MarcSerraPeralta/custom-keyboards/documentation/build_guide/hotswap_socket_mounting/hotswap_sockets_installation_1.webp

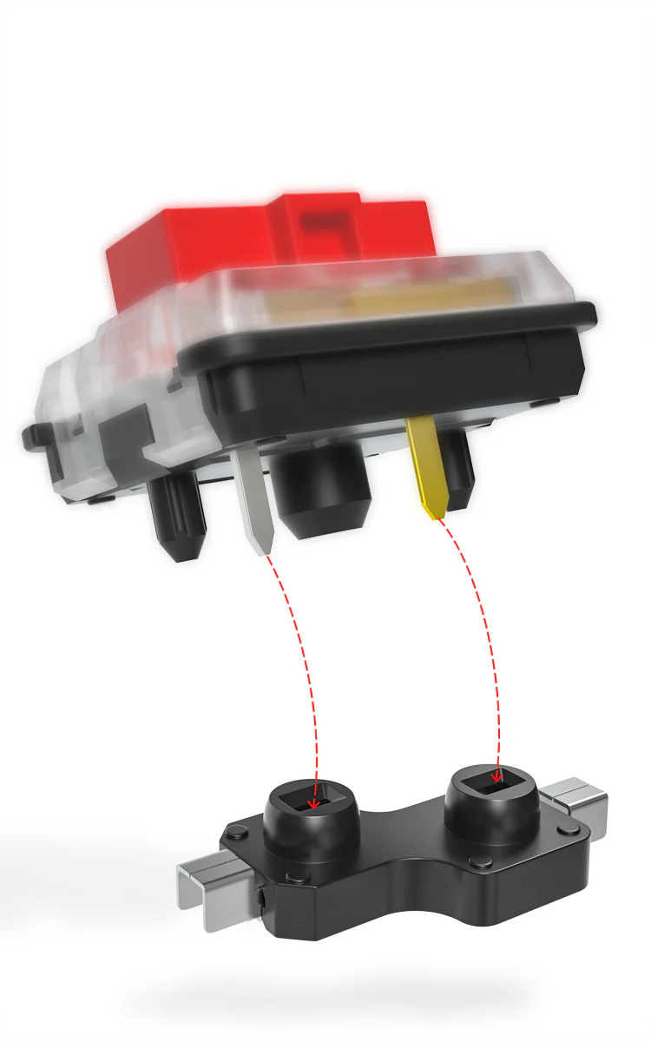
documentation/build_guide/hotswap_socket_mounting/hotswap_sockets_installation_1.webp
