MarcSerraPeralta/custom-keyboards/README.md

# custom-keyboards

Documentation for designing and building custom keyboards.
