MarcSerraPeralta/custom-keyboards/HARDWARE.md

# Hardware

This is a list of the hardware that I bought to build my keyboard.

- **Kailh Hotswap Sockets Choc / Black 50 x**, 1 x 7.95€ [splikb](https://splitkb.com/products/kailh-hotswap-sockets?variant=39472161456205)
- **Kailh Low Profile Choc Switches Burnt Orange (tactile / 70gf) / 10 switches**, 4 x 5.99€ [splitkb](https://splitkb.com/products/kailh-low-profile-choc-switches?variant=43565434339587)
- **Blank MBK Choc Low Profile Keycaps 10 x 1u / White**, 3 x 4.45€ [splitkb](https://splitkb.com/products/blank-mbk-choc-low-profile-keycaps?variant=31811487039565)
- **Blank MBK Choc Low Profile Keycaps 10 x 1u / Black**, 1 x 4.45€ [splitkb](https://splitkb.com/products/blank-mbk-choc-low-profile-keycaps?variant=31811491987533)
