MarcSerraPeralta/custom-keyboards/documentation/hardware_design_guide/07_extra_hardware_features.md

# Extra hardware features

Here, I just list some extra hardware features that I will include in my design:

### Reset button

A reset button resets the microcontroller (needed for flashing the device or if something goes wrong). 

From the [nice!nano documentation](https://nicekeyboards.com/docs/nice-nano/getting-started/), 

> "One of the great things about the nice!nano is how easy it is to flash the device. 
To jump into the bootloader all you need to do is double tap reset. 
You can do this by either double tapping your reset button on your keyboard, 
or you can double tap RST and GND pins on the nice!nano quickly with tweezers."

Therefore, the reset button needs to connect the ground (GND) and the reset (RST).

### On/Off button 

This is only important for wireless keyboards as one should turn it off to
avoid wasting battery. 

### Drawings on the PCB

It is possible to draw some vector graphics in the PCB (using Silkscreen). 

### Mounting holes

Mounting holes in the PCB are useful to hold it inside the case.
