MarcSerraPeralta/custom-keyboards/my_keyboard/v0-3/my_keyboard_layout_v0-3.pdf

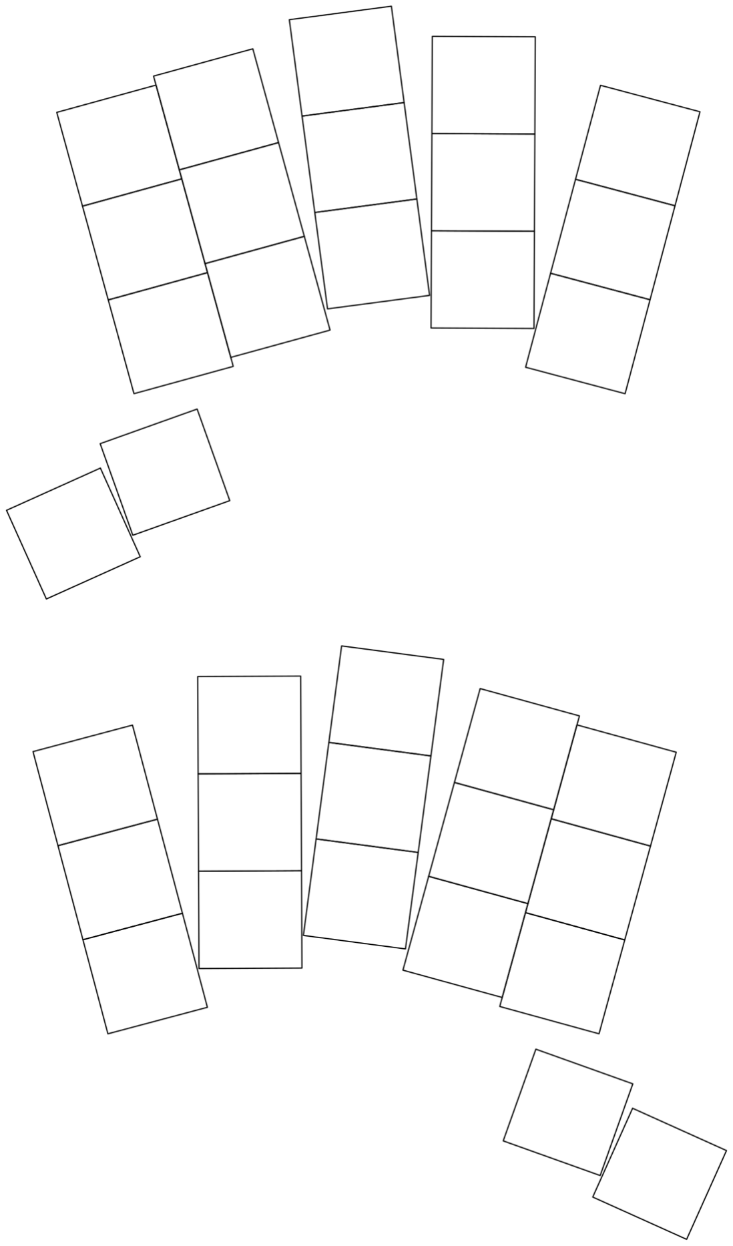
[picture p3: figure]
