MarcSerraPeralta/custom-keyboards/my_keyboard/v0-2/my_keyboard_layout_v0-2.pdf

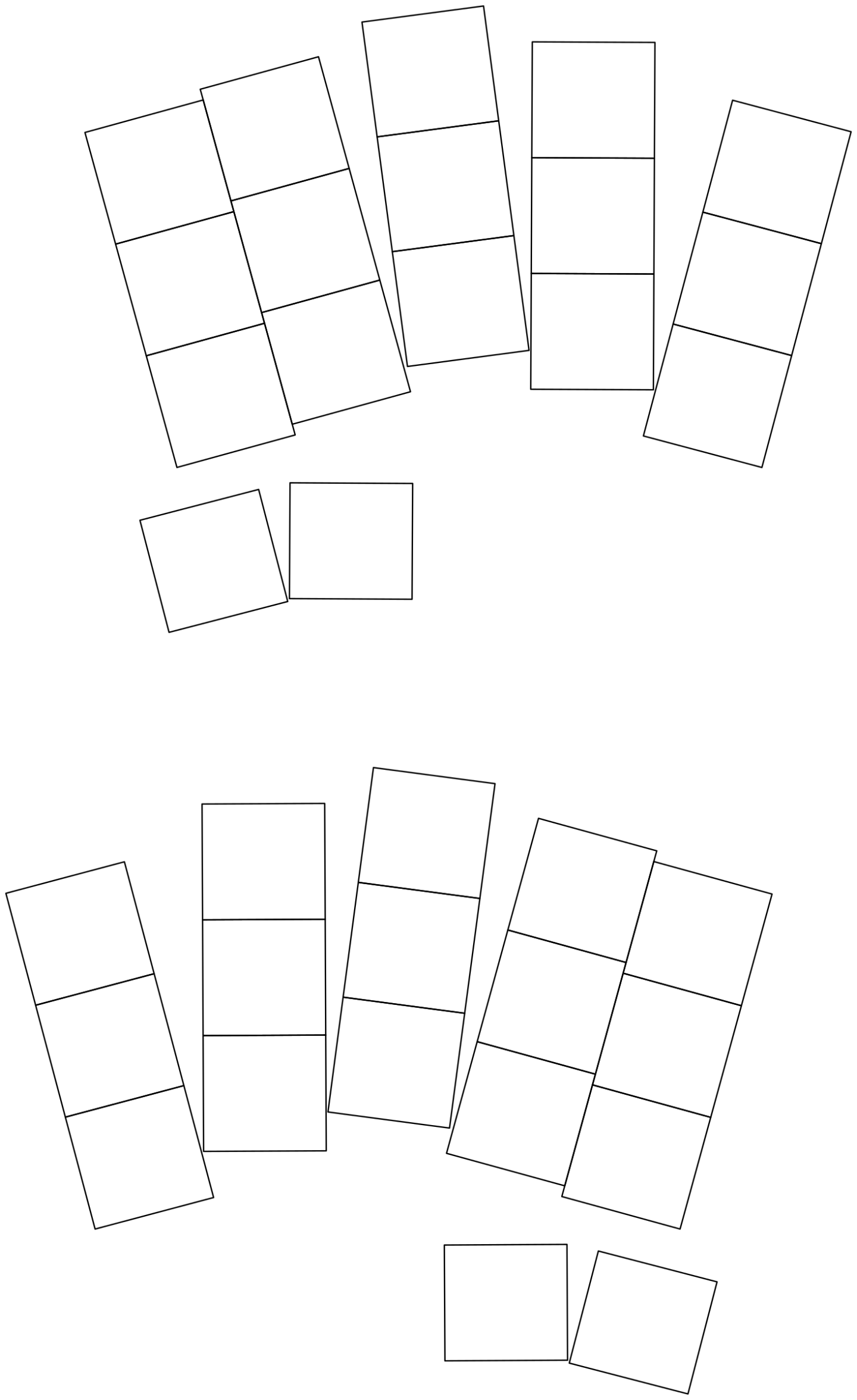
[picture p4: figure]
