MarcSerraPeralta/custom-keyboards/my_keyboard/v0-1/my_keyboard_layout_v0-1.pdf

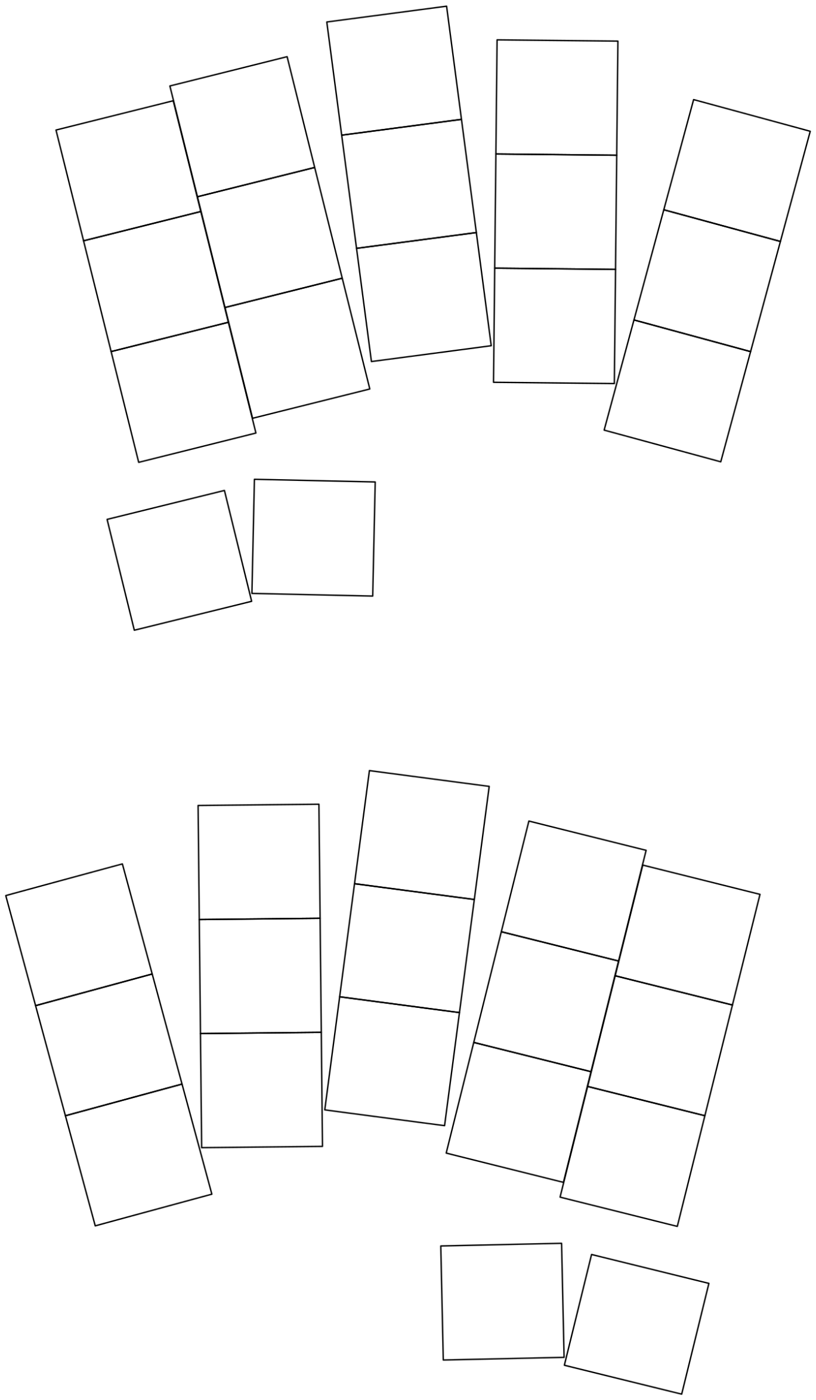
[picture p5: figure]
