MarcSerraPeralta/custom-keyboards/documentation/hardware_design_guide/hardware_elements/kailh_choc_hotswap_socket/kailh_choch_hotswap_sockets.webp

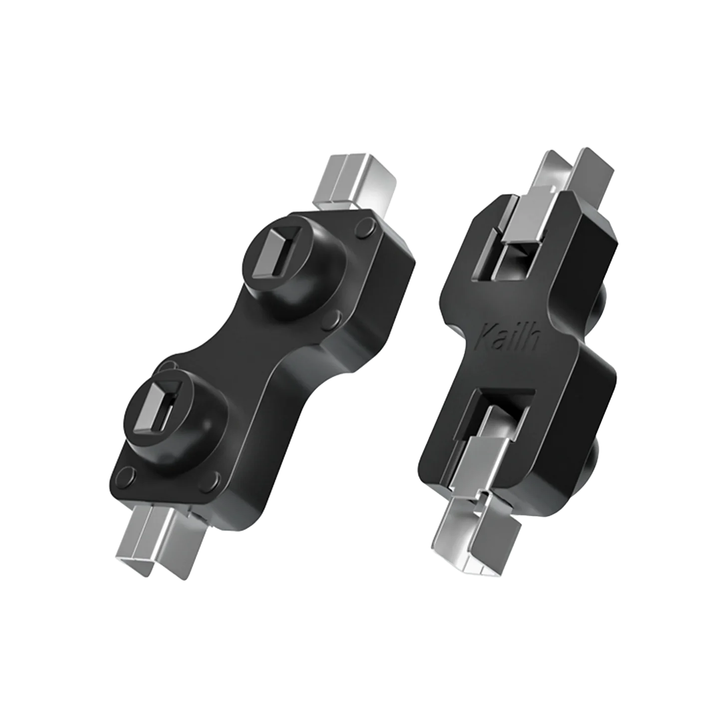
documentation/hardware_design_guide/hardware_elements/kailh_choc_hotswap_socket/kailh_choch_hotswap_sockets.webp
