MarcSerraPeralta/custom-keyboards/documentation/hardware_design_guide/hardware_elements/kailh_choc_switch/choc-v1-vs-v2_dimensions.jpg

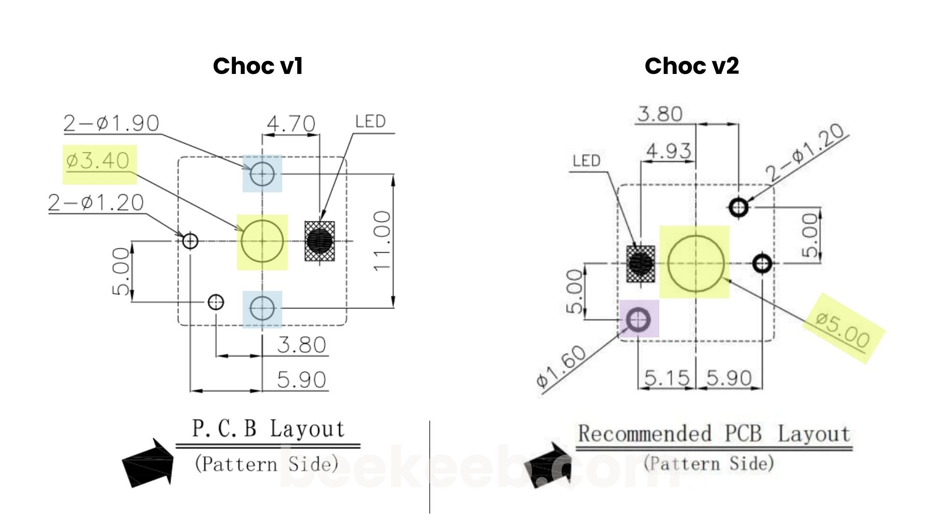
documentation/hardware_design_guide/hardware_elements/kailh_choc_switch/choc-v1-vs-v2_dimensions.jpg
