MarcSerraPeralta/custom-keyboards/documentation/hardware_design_guide/hardware_elements/SSSS811101_power_switch/SSSS811101_electrical_circuit.png

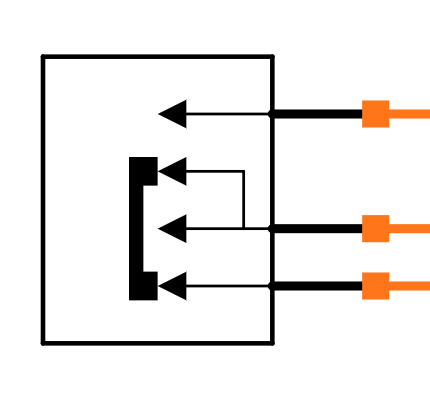
documentation/hardware_design_guide/hardware_elements/SSSS811101_power_switch/SSSS811101_electrical_circuit.png
