MarcSerraPeralta/custom-keyboards/force-travel_diagram/kailh-choc-v2_low-profile_brown_switch.webp

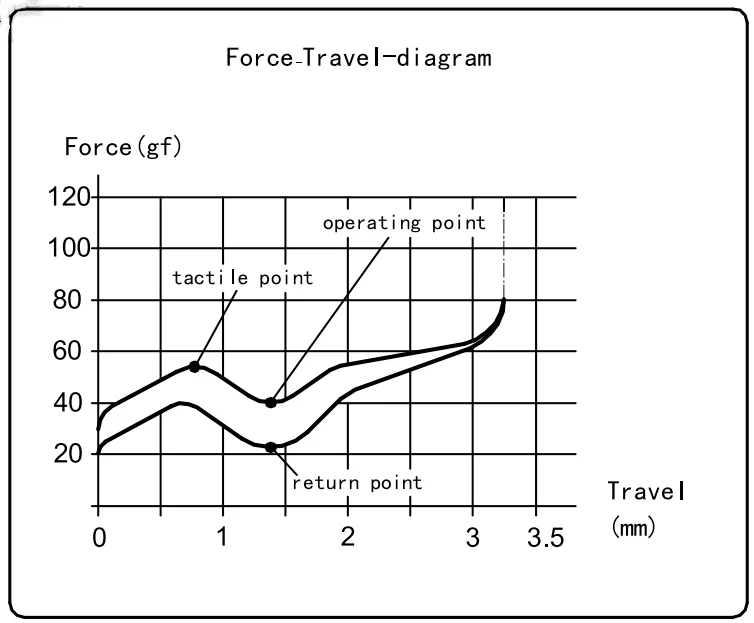
force-travel_diagram/kailh-choc-v2_low-profile_brown_switch.webp
