MarcSerraPeralta/custom-keyboards/force-travel_diagram/kailh-choc-v2_low-profile_red_switch.webp

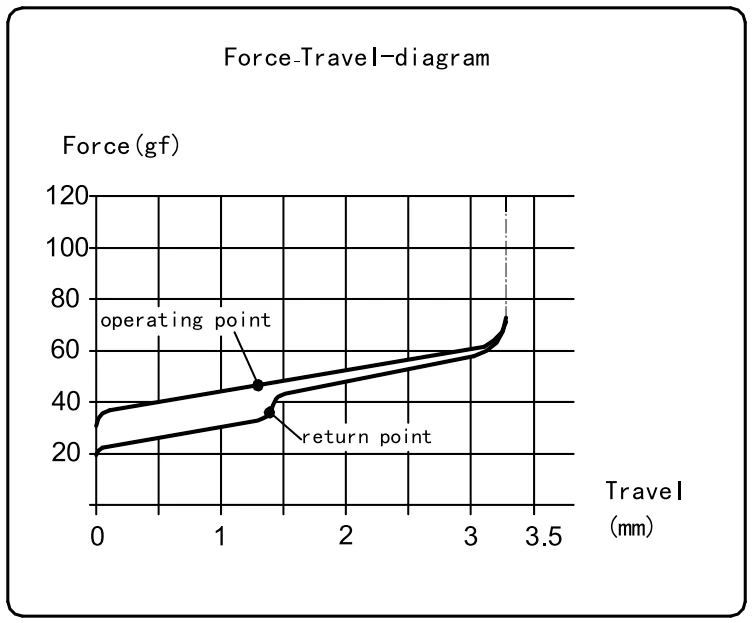
force-travel_diagram/kailh-choc-v2_low-profile_red_switch.webp
