MarcSerraPeralta/custom-keyboards/force-travel_diagram/sunset_switch.png

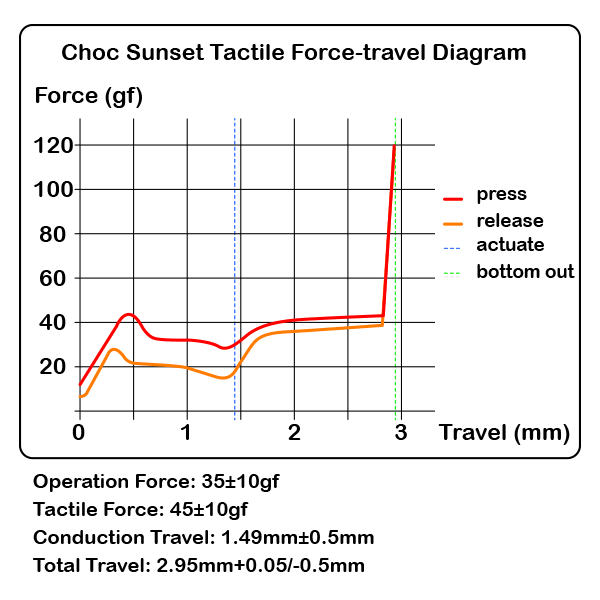
force-travel_diagram/sunset_switch.png
