MarcSerraPeralta/custom-keyboards/my_keyboard/v0-2/my_keyboard_layout_v0-2.png

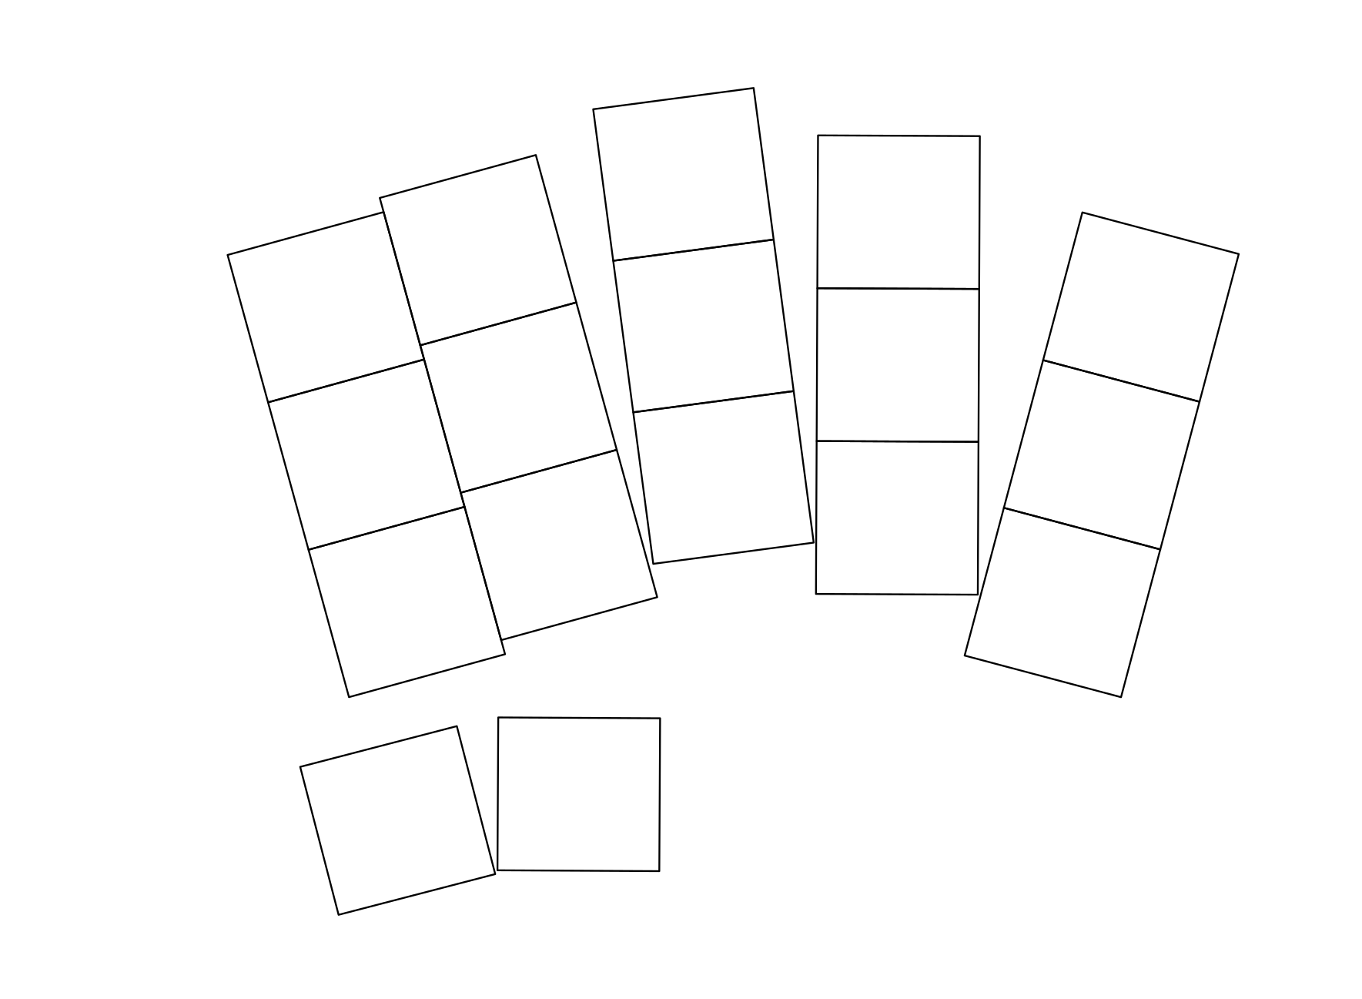
my_keyboard/v0-2/my_keyboard_layout_v0-2.png
