MarcSerraPeralta/custom-keyboards/my_keyboard/v0-3/my_keyboard_layout_v0-3_draft.jpeg

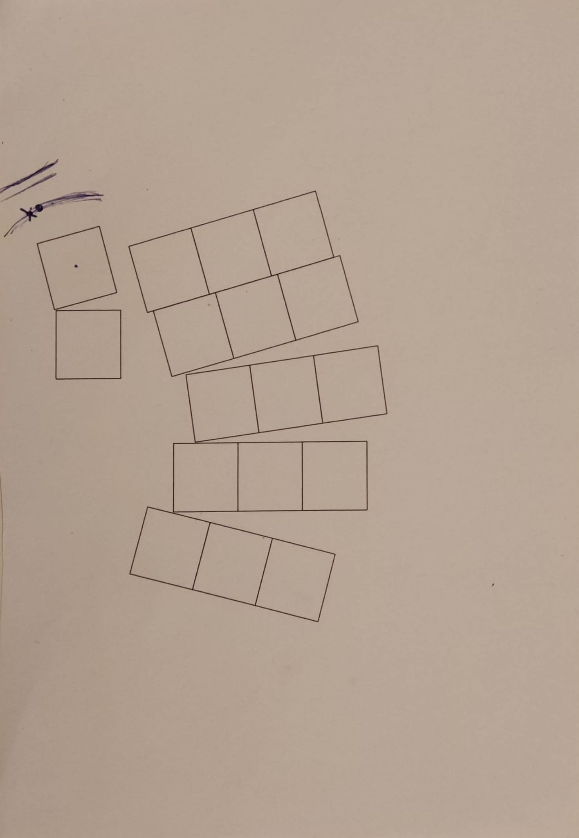
my_keyboard/v0-3/my_keyboard_layout_v0-3_draft.jpeg
