MarcSerraPeralta/custom-keyboards/documentation/build_guide/list_parts.rst

General list for the parts
==========================

The following list has been extracted from the description of the following youtube video:
https://www.youtube.com/watch?v=UKfeJrRIcxw

Basic parts list:

PCB (I ordered mine from https://jlcpcb.com )
Kailh Choc switches (I used the light blue liner ones from https://splitkb.com/products/kailh-lo...
MBK Blank Keycaps https://splitkb.com/products/blank-mb...
Hotswap Sockets (Choc) https://splitkb.com/products/kailh-ho...
Socket pins (pins only) https://splitkb.com/products/mill-max...
Full height machine pin sockets https://mechboards.co.uk/products/mac...
Better version of reset button (matches the footprint better but more expensive) https://www.aliexpress.com/item/10050...
Battery connector (2p curved) https://www.aliexpress.com/item/10050... (Uses the bat footprint in my Ergogen fork)
Power switch https://www.aliexpress.com/item/40006... (Uses the pcm12 footprint in my Ergogen fork)
Nice!nano v2 https://splitkb.com/products/nice-nano or https://mechboards.co.uk/products/nic... 
Batteries: https://www.ebay.co.uk/itm/194001009975
