MarcSerraPeralta/custom-keyboards/my_keyboard/v0-3/output/outlines/first.dxf

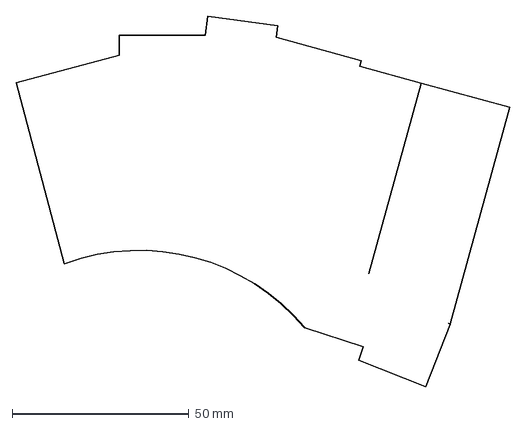
[picture p17: CAD file, 2025-01-26]
my_keyboard/v0-3/output/outlines/first.dxf
139.7 x 104.8 mm
