MarcSerraPeralta/custom-keyboards/my_keyboard/v0-3/output/outlines/second.dxf

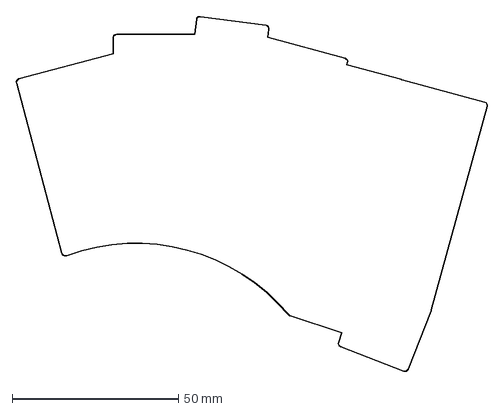
[picture p18: CAD file, 2025-01-26]
my_keyboard/v0-3/output/outlines/second.dxf
141.8 x 106.9 mm
