MarcSerraPeralta/custom-keyboards/my_keyboard/v0-3/output/outlines/keycaps.dxf

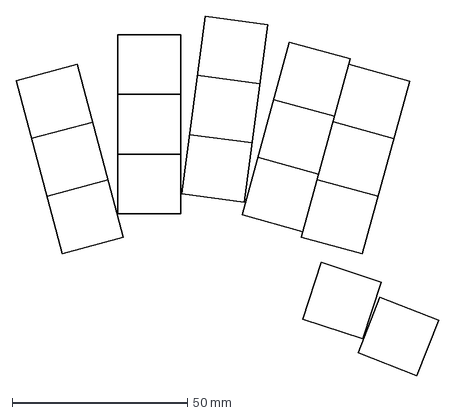
[picture p19: CAD file, 2025-01-06]
my_keyboard/v0-3/output/outlines/keycaps.dxf
120.3 x 102.4 mm
