MarcSerraPeralta/custom-keyboards/my_keyboard/v0-3/output/outlines/elements.dxf

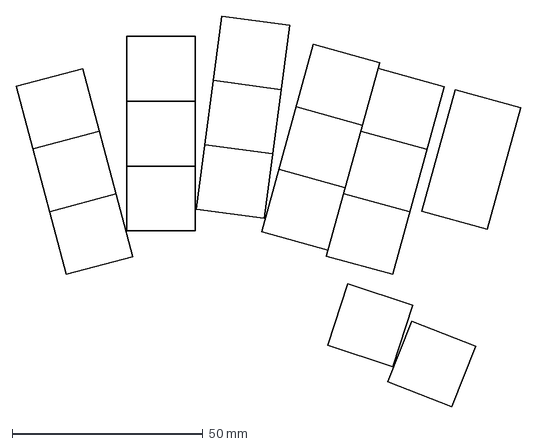
[picture p20: CAD file, 2025-01-06]
my_keyboard/v0-3/output/outlines/elements.dxf
132.2 x 102.4 mm
