MarcSerraPeralta/custom-keyboards/my_keyboard/v0-3/output/outlines/raw.dxf

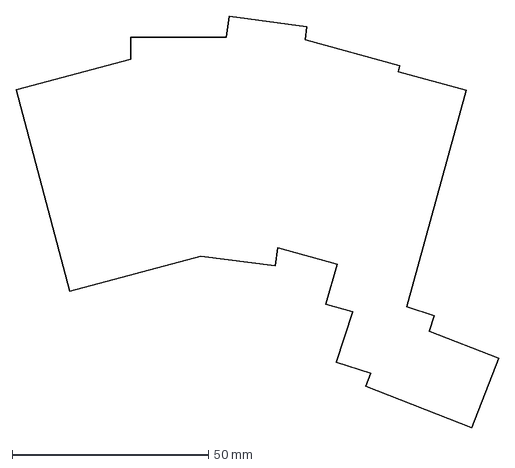
[picture p21: CAD file, 2025-01-06]
my_keyboard/v0-3/output/outlines/raw.dxf
122.9 x 104.8 mm
