MarcSerraPeralta/custom-keyboards/my_keyboard/v0-3/output/outlines/mcu.dxf

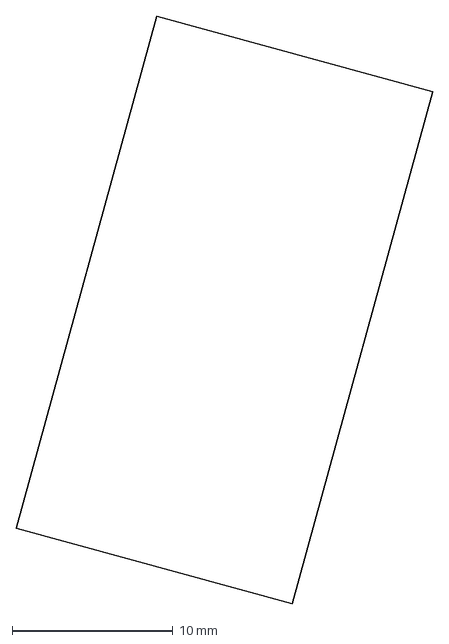
[picture p22: CAD file, 2025-01-06]
my_keyboard/v0-3/output/outlines/mcu.dxf
25.9 x 36.5 mm
