MarcSerraPeralta/custom-keyboards/documentation/hardware_design_guide/03_switches_and_keycaps.md

# Sockets, key switches, and keycaps

The definitions for the elements in the title are:
- **sockets** = place where the key is hold. 
    - *Hotswapable sockets* allow to remove the keys without having to desolder them. 
    (50 hotswapable sockets ~8€).
- **key switch** = actual "button"/switch that triggers if a key has been pressed. 
    It does not include the top cover.
- **keycap** = cover for the switch where (usually) the letters are printed on. 

There are big switches families, e.g. MX and Kailh.
Inside each family, there is a huge variety of keycaps and switch options (people can be very picky).
For custom keyboards, I have only seen mechanical switches being used, however
there exist more types. 

The main choices for switches depend on the "feel" when pressing the
switch and its "sound" (people even mod or lube switches for achieving a 
specific sound).

Regarding keycaps, the main options are the "finish" in the surface, the profile
of the keycap (flat, rounded, ...), and art decoration for the letter.

### Types of switches

**Classification based on how they feel/sound:**

- Clicky
- Tactile
- Linear

A good description of all of them is: 

- ["Clicky Vs Tactile Vs Linear Mechanical Keyboard Switches with Sound Tests And Examples" by Switch and Click](https://www.youtube.com/watch?v=MbL9j06siA0)

**Classification on their travel distance:**

- "Normal"
- Low profile
- Ultra low profile (scissors)

The type of switches that MacBooks have are super low profile, like the Cherry MX Ultra Low Profile (ULP).
These switches are not hotswappable and seem to be difficult to hand-solder.
An example of custom keyboard using these switches can be found in
[this reddit post](https://www.reddit.com/r/ErgoMechKeyboards/comments/zpo9h6/mask200_4x6_split_keyboard_with_cherry_mxulp_keys/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)
The switches can be bought from [reichelt](https://www.reichelt.com/hu/en/cherry-mx-ultra-low-profile-rgb-pushbutton-module-cherry-mx6c-k3nb-p335040.html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).
A similar switch is the [Kahli X-switch](https://www.reddit.com/r/ErgoMechKeyboards/comments/xavii7/kailh_x_scissor_switch/).

**Modifiers of the switches**

- **O-rings** can be used to reduce the travel distance of the keys [ref](https://www.reddit.com/r/ErgoMechKeyboards/comments/17rnxp0/reducing_travel_distance_on_choc_switches/).
[Guide](https://blog.zsa.io/robins-repairs-o-rings/) of how to install O-rings to choc keys.

**Footprints of the switches (for Ergogen)**

- [github.com/daprice/keyswitches.pretty](https://github.com/daprice/keyswitches.pretty)

### Types of keycaps

The following website contains a good explanation of the differences in keycaps:

- ["The Ultimate Guide to Keycaps: Material, Profile, and Beyond" by Redragon](https://redragonshop.com/blogs/community/the-ultimate-guide-to-keycaps-material-profile-and-beyond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)
