MarcSerraPeralta/custom-keyboards/documentation/build_guide/soldering_microcontroller.rst

Socketing the the microcontroller
=================================

The steps for socketing the nice!nano (or equivalently any other microcontroller)
can be found on its documentation 
(https://nicekeyboards.com/docs/nice-nano/getting-started#socketing-the-nicenano),
which they refer to the following website for images:
https://www.40percent.club/p/socketing-pro-micro.html
