MarcSerraPeralta/custom-keyboards/documentation/build_guide/keyswitches.rst

Example of keyboard with very thing switches:
https://www.reddit.com/r/ErgoMechKeyboards/comments/1cfg3vr/mikefive_a_kailh_pg1316_keyboard/
