MarcSerraPeralta/custom-keyboards/documentation/firmware_design_guide/firmware.md

Keyboard software
=================

Seems like the QMK and ZMK are very similar in functionality (maybe QMK a little bit more customizable). 
However, ZMK supports wireless keyboards while QMK does not. So probably choose ZMK. 

Most wired Arduino Pro Micro and RP2040 based keyboards use the popular QMK firmware.
Meanwhile, wireless keyboards leveraging the Nice!Nano microcontroller typically employ ZMK instead.

Writing a custom board in ZMK
-----------------------------

This is a great video that introduces how to build a custom board in ZMK:
https://www.youtube.com/watch?v=O_urj-rF3bQ

This is the official documentation of ZMK explaning all the details to build
a custom board:
https://zmk.dev/docs/user-setup
https://zmk.dev/docs/development/hardware-integration/new-shield

Keymaps in ZMK
--------------

This is a good video about all the possible keymap functionalities in ZMK:
https://www.youtube.com/watch?v=Kx8F4xI5yno&t=10s
