MarcSerraPeralta/custom-keyboards/documentation/build_guide/keymaps.rst

Keymaps
=======

An option for the 36-key keyboard is the miryoku keymap:
https://keymapdb.com/keymaps/manna_harbour/
