MarcSerraPeralta/custom-keyboards/documentation/hardware_design_guide/06_split_keyboards_reversible_pcb.pdf

# ↓ a efree

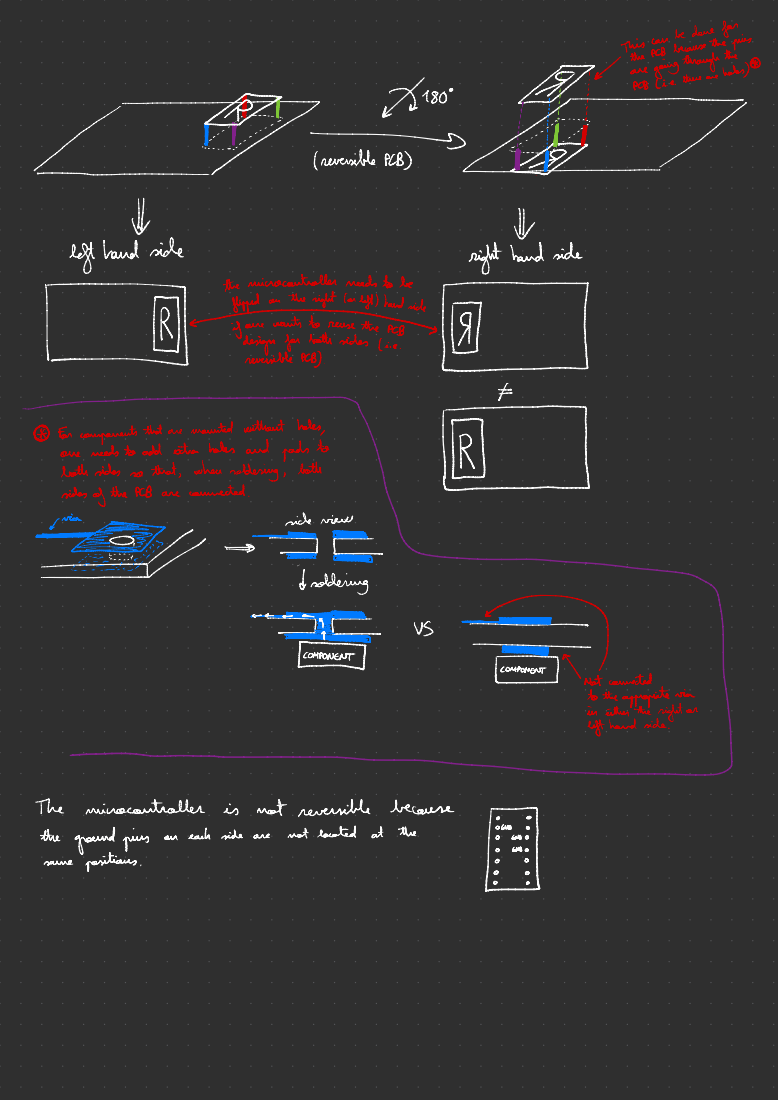
[picture p33: page 1]
This; left hand side; right hand side; thericrocontrollerdtoa DiBaide; If one; wants to reuse the PCB; ⑪ For components that are; mounted without holes; one both; sides; needs; the; so PCB; add that; are; connected; when; holes soldering; and; pads; both; 3 = via; The; minocontroller is; not reversible because; the ground pins on; each side are; not located at the; same; positions ,

design for both sides (rie .
reversible PCB) .

Not connected
to the appropriate via
in either the right or
left hand side.
