MarcSerraPeralta/custom-keyboards/my_keyboard/v0-3/output/pcbs/main_pcb_routed.kicad_pcb

## KiCad design my_keyboard/v0-3/output/pcbs/main_pcb_routed.kicad_pcb (2025-01-26)

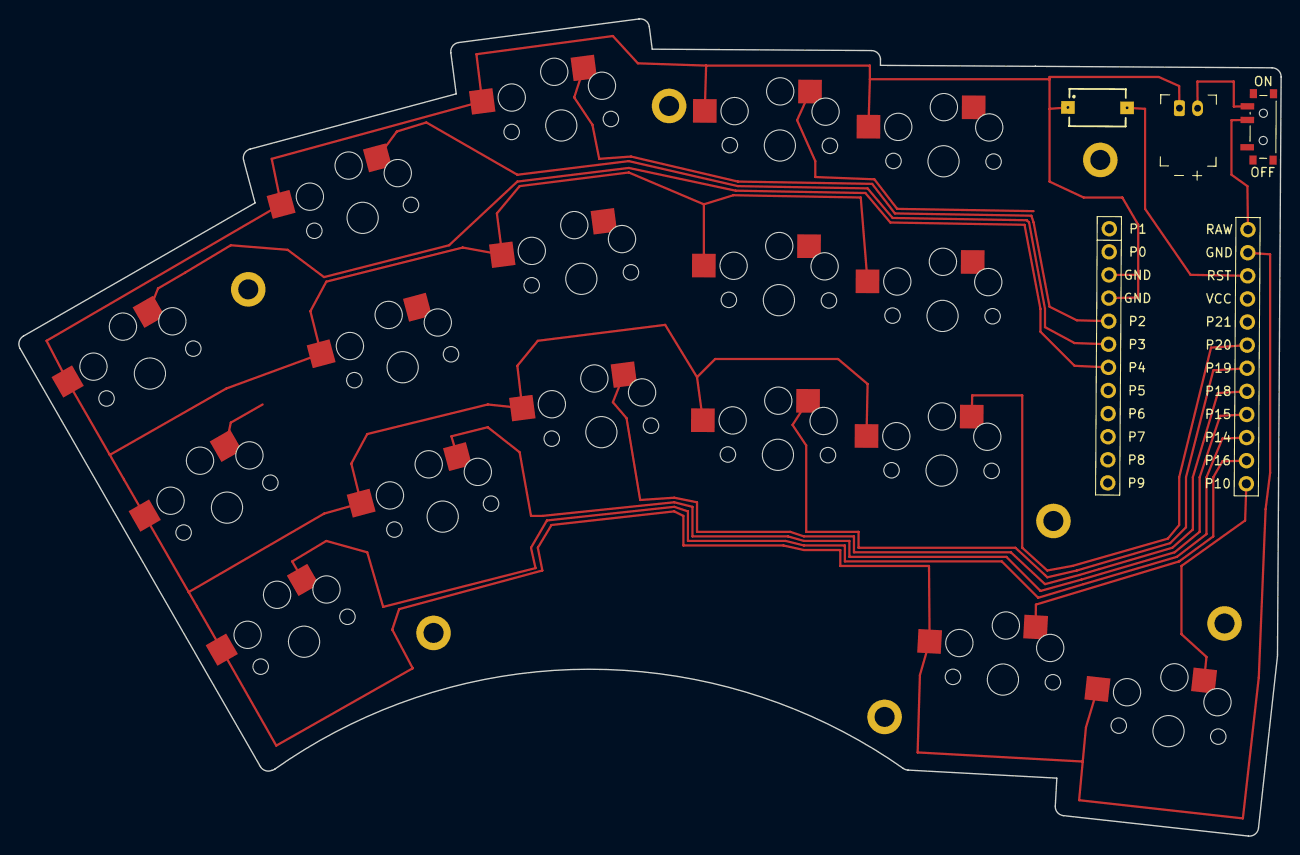
[picture p34: board main_pcb_routed.kicad_pcb from above]

Board: 2 copper layers, 138.7 x 89.8 mm, 28 parts (0 on the bottom side), 21 nets.

Parts:
H1, H2, H3, H4, H5, H6, H7: mounting_hole_plated
JST1: battery_connector_jst_ph_2
MCU1: mcu_supermini_nrf52840
PWR1: power_switch_smd_side
S1, S2, S3, S4, S5, S6, S7, S8, S9, S10, S11, S12, S13, S14, S15, S16, S17: PG1350
S18: 434121025816

Connections:
GND: JST1.1, MCU1.2, MCU1.21, MCU1.22, S1.2, S2.2, S3.2, S4.2, S5.2, S6.2, S7.2, S8.2, S9.2, S10.2, S11.2, S12.2, S13.2, S14.2, S15.2, S16.2, S17.2, S18.1
P0: MCU1.23, S12.1
P1: MCU1.24, S15.1
P2: MCU1.20, S9.1
P3: MCU1.19, S6.1
P4: MCU1.18, S3.1
P5: MCU1.17, S14.1
P6: MCU1.16, S11.1
P7: MCU1.15, S8.1
P8: MCU1.14, S5.1
P9: MCU1.13, S2.1
P10: MCU1.12, S17.1
P14: MCU1.10, S1.1
P15: MCU1.9, S4.1
P16: MCU1.11, S16.1
P18: MCU1.8, S7.1
P19: MCU1.7, S10.1
P20: MCU1.6, S13.1
PWR_SW: JST1.2, PWR1.1, PWR1.3
RAW: MCU1.1, PWR1.2
RST: MCU1.3, S18.2
