MarcSerraPeralta/custom-keyboards/examples/example_case.yaml

units:
  # Parameters
  row_spacing: 1cy

  pinky_rotation: 5 # degrees rotation relative to zone rotation
  pinky_stagger: 0 # mm, relative to previous column
  pinky_spread: 1cx # mm, relative to previous column

  ring_rotation: 3
  ring_stagger: 0.45cy
  ring_spread: 1.05cx

  middle_rotation: 0
  middle_stagger: 1
  middle_spread: 1.1cx

  index_rotation: -1
  index_stagger: -3
  index_spread: 1cx

  inner_rotation: -2
  inner_stagger: -5
  inner_spread: 1cx

  usb_cutout_x:  51.64
  usb_cutout_y: 2.10
  usb_cutout_r: -15.5

  # Constants
  choc_cap_x: 17.5
  choc_cap_y: 16.5

  choc_plate_thickness: 1.2
  mx_plate_thickness: 1.5

points:
  rotate: 0
  key: # each key across all zones will have these properties
    bind: 5
    width: choc_cap_x
    height: choc_cap_y
    tags:
      1u: true
    footprints: # These footprints will be added for each of the points
      choc_hotswap:
        type: choc
        nets:
          to: "{{key_net}}"
          from: GND
        params:
          reverse: false
          hotswap: true
          # Don't show a model for this since 'choc' already loads the model
          model: false
          keycaps: false
      choc:
        type: choc
        anchor:
          rotate: 180
        nets:
          to: "{{key_net}}"
          from: GND
        params:
          keycaps: true
          reverse: false
  zones:
    alphas:
      rows:
        bottom.padding: row_spacing
        home.padding: row_spacing
        top.padding: row_spacing
      columns:
        pinkycluster:
          key:
            splay: pinky_rotation
          rows:
            bottom.skip: true
            home.key_net: P106
            top.skip: true
        pinky:
          key:
            splay: pinky_rotation - pinky_rotation
            stagger: pinky_stagger
            spread: pinky_spread
          rows:
            bottom.key_net: P104
            home.key_net: P102
            top.skip: true
        ring:
          key:
            splay: ring_rotation - pinky_rotation
            stagger: ring_stagger
            spread: ring_spread
          rows:
            bottom.key_net: P101
            home.key_net: P103
            top.key_net: P100
        middle:
          key:
            splay: middle_rotation - ring_rotation
            stagger: middle_stagger
            spread: middle_spread
          rows:
            bottom.key_net: P022
            home.key_net: P029
            top.key_net: P030
        index:
          key:
            splay: index_rotation - middle_rotation
            stagger: index_stagger
            spread: index_spread
          rows:
            bottom.key_net: P031
            home.key_net: P004
            top.key_net: P005
        inner:
          key:
            splay: inner_rotation - index_rotation
            stagger: inner_stagger
            spread: inner_spread
          rows:
            bottom.key_net: P007
            home.key_net: P109
            top.key_net: P012
    thumbkeys:
      anchor:
        ref: alphas_index_bottom
        shift: [ 0.5cx, -1cy - 2]
      columns:
        near:
          key:
            splay: -10
            stagger: -5
            origin: [ 0, -0.5cy ]
            key_net: P009
        home:
          key:
            spread: 19
            stagger: 0.25cy # Move up by 0.25cy so a 1.5cy keycap lines up with the bottom
            splay: -15 # -25 degrees cumulative
            origin: [-0.5choc_cap_y, -0.75choc_cap_x] # Pivot at the lower left corner of a 1.5u choc key
            height: choc_cap_x
            width: 1.5choc_cap_y
            rotate: 90
            tags:
              15u: true
              1u: false
            key_net: P010
      rows:
        thumb:
          padding: 0
outlines:
  _bottom_arch_circle:
    - what: circle
      radius: 500
      where:
        ref: alphas_middle_bottom
        shift: [-95, -525]
  _top_arch_circle:
    - what: circle
      radius: 200
      where:
        ref: alphas_middle_bottom
        shift: [0, -155]
  _main_body_circle:
    - what: circle
      radius: 70
      where:
        ref: alphas_middle_bottom
        shift: [0, 0]
  _usb_c_cutout:
    - what: rectangle
      size: [9.28, 6.67]
      where: &usbanchor
        ref: alphas_middle_top
        shift: [ usb_cutout_x, usb_cutout_y ]
        rotate: usb_cutout_r
  # Make a crescent by overlapping two circles then cut the main body with a third circle
  _main: [
      +_top_arch_circle,
      -_bottom_arch_circle,
      ~_main_body_circle
  ]
  _fillet:
    - what: outline
      name: _main
      fillet: 6
  combined: [
      _fillet,
      -_usb_c_cutout
  ]
  _switch_cutouts:
    - what: rectangle
      where: true
      asym: source
      size: 14 # Plate cutouts are 14mm * 14mm for both MX and Choc
      bound: false
  switch_plate:
    [ combined, -_switch_cutouts]
cases:
  switchplate:
    - what: outline
      name: switch_plate
      extrude: choc_plate_thickness
  bottom:
    - what: outline
      name: combined
      extrude: choc_plate_thickness
