MarcSerraPeralta/custom-keyboards/(commit log)

2024-10-09 Add current information
2024-11-10 Update docs
    [2_keyboard_names.csv]
2025-01-04 reversible PCBs
2025-01-06 Add complete v0.3
    [elements.dxf, first.dxf, keycaps.dxf, main_pcb.kicad_pcb, mcu.dxf, raw.dxf, second.dxf]
2025-01-25 Add docs and v0-3
    [02_keyboard_names.csv, main_pcb_preliminary_routing.kicad_pcb]
2025-01-26 Move elements in PCB so that routing is easier
    [first.dxf, main_pcb.kicad_pcb, main_pcb_correct_routing.kicad_pcb, second.dxf]
2025-01-26 Solve bug in P0 and P1 nets
    [main_pcb.kicad_pcb, main_pcb_correct_routing.kicad_pcb, main_pcb_preliminary_routing.kicad_pcb, main_pcb_routed.kicad_pcb]
2026-05-25 Improve documentation and switch to Markdown
    [02_keyboard_names.csv]
